Factorem-io/Duple/KiCAD Duple/Duple Schematic.pdf

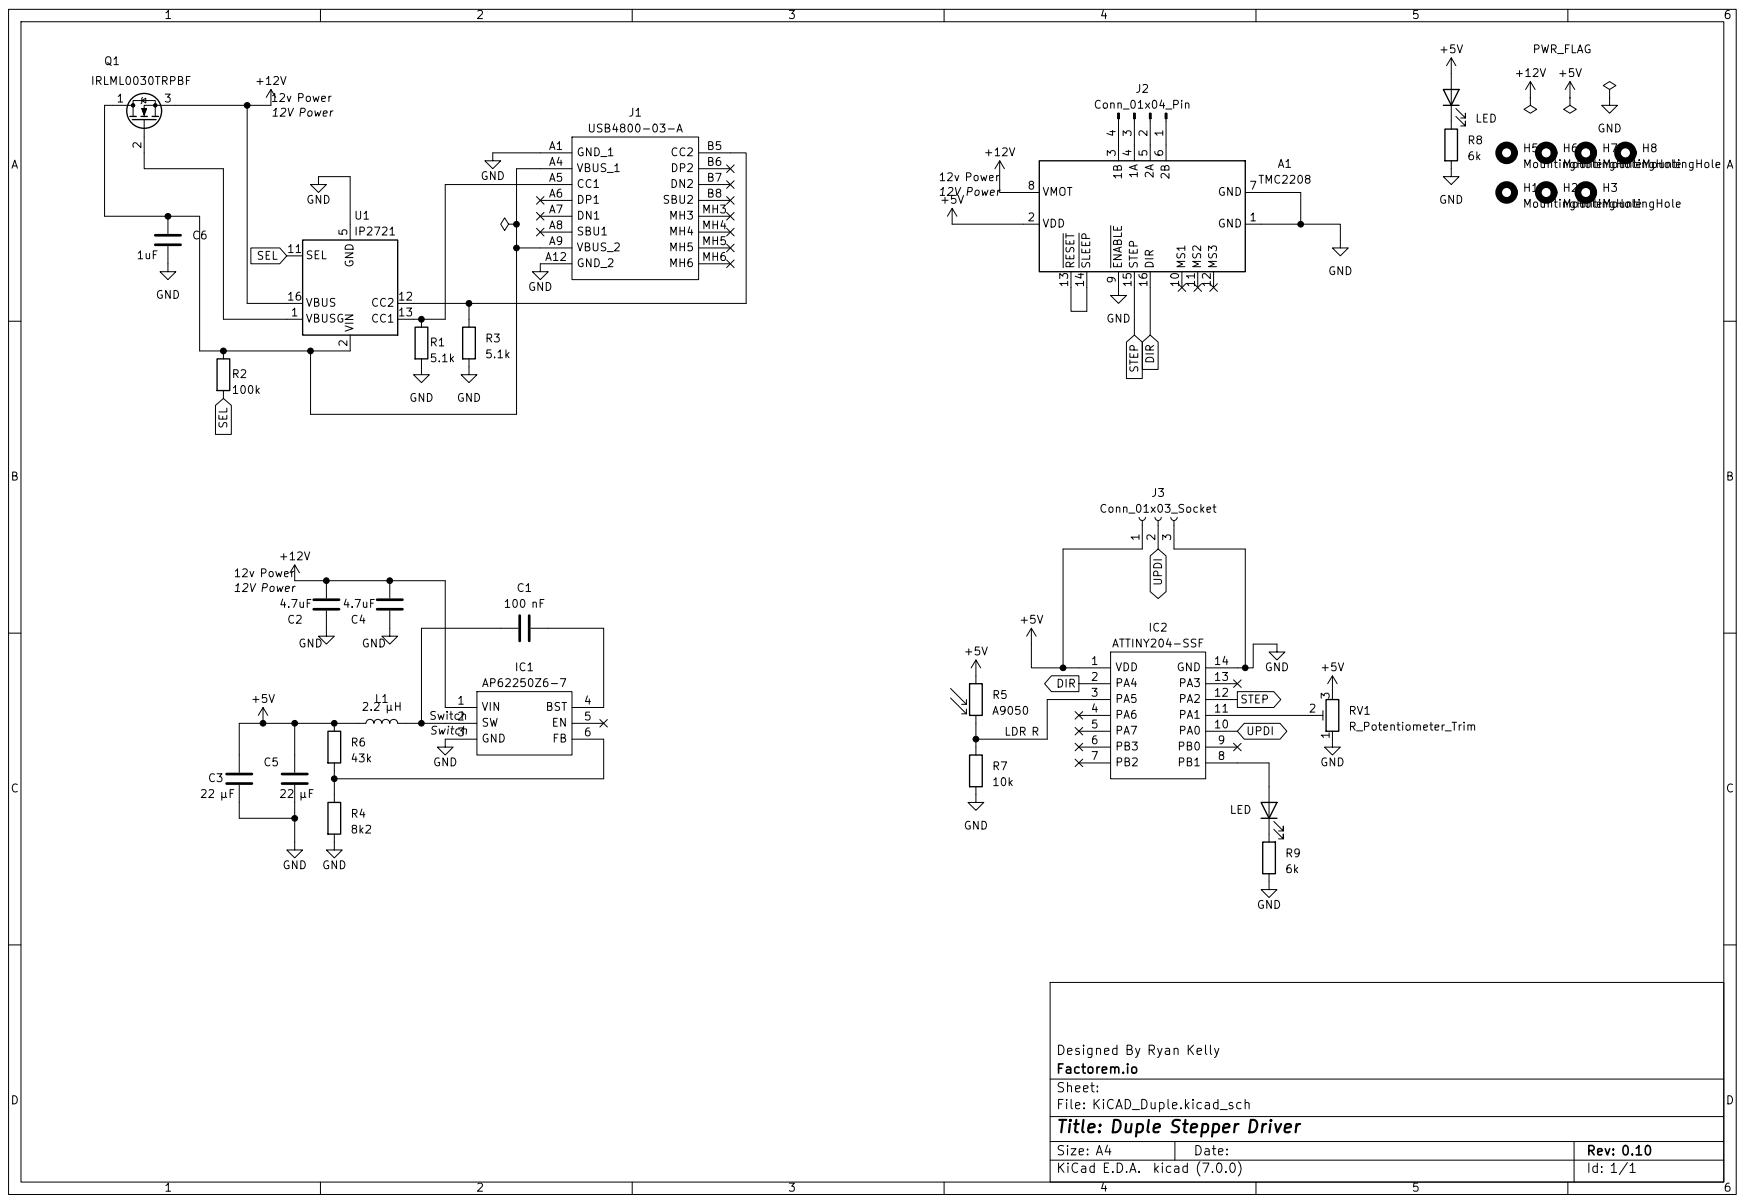
[picture p1: page 1]
