Factorem-io/Duple/(commit log)

2023-03-14 Uploading Arduino Code as-is
2023-04-18 Adding CAD to Duple for those that are curious
2023-04-18 Uploading the relevant KiCAD files
    I wouldn't recommend manufacturing these boards exactly. The parts are dumb small. If enough people are interested in making their own I'll update the boards and design them for automated assembly at one of the PCB assembly houses. Reach out if you're one of those people that is interested, right now it feels like I'm just shouting into the void! :D
